lesomnus/pi400-holder/previews/connection_overview.png

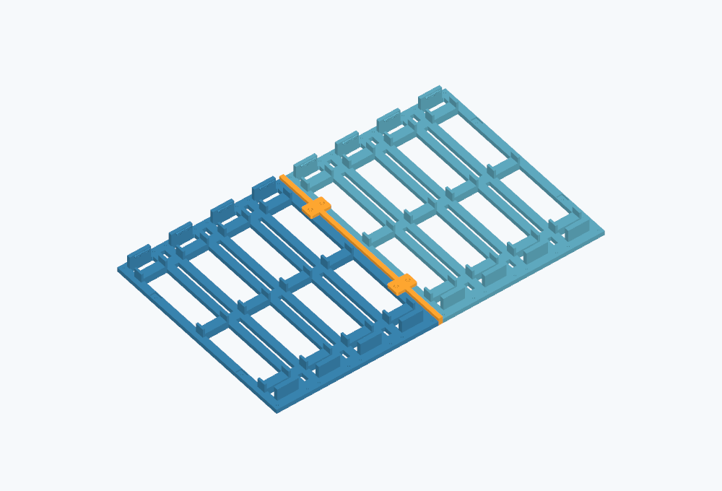
previews/connection_overview.png
