lesomnus/pi400-holder/previews/connector_underside.png

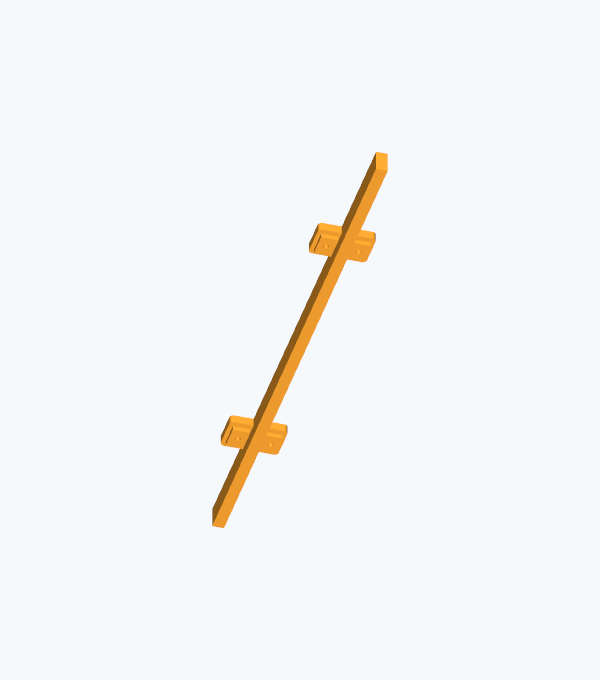
previews/connector_underside.png
