lesomnus/pi400-holder/previews/repeatable_connection.png

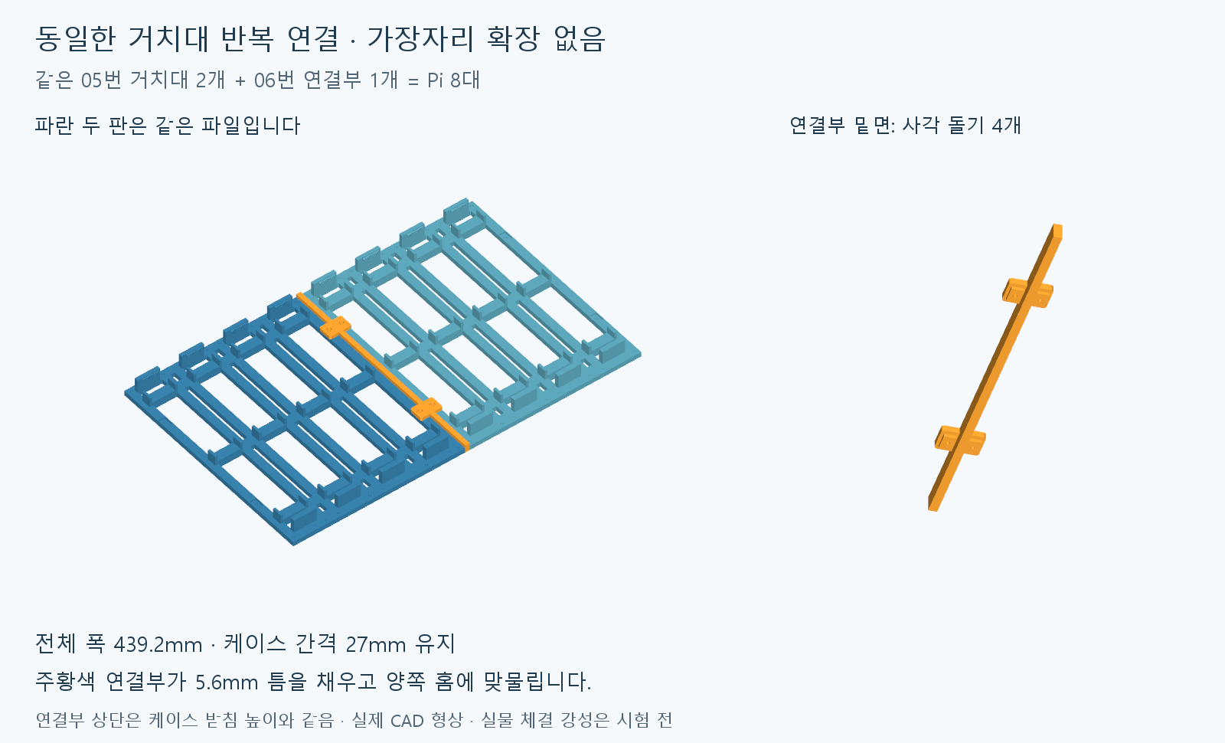
previews/repeatable_connection.png
