lesomnus/pi400-holder/reference/reference.png

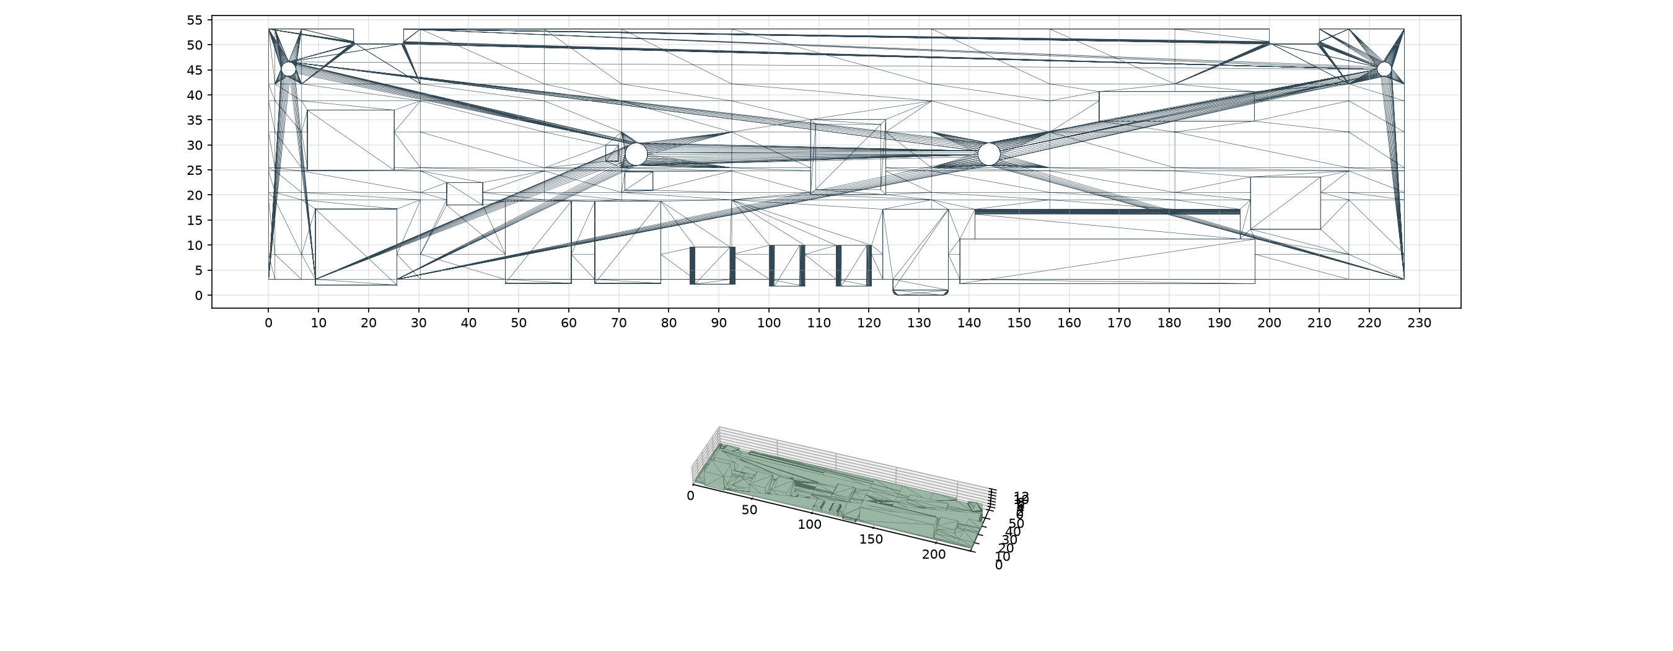
reference/reference.png
