lesomnus/pi400-holder/STEP/two_quad_connection_assembly.step

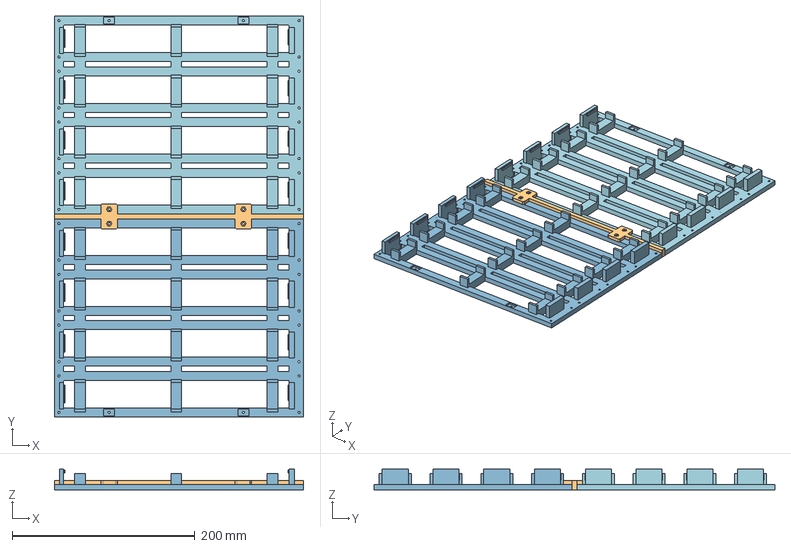
[picture p7: CAD file, 2026-10-20]
STEP/two_quad_connection_assembly.step
273.0 x 439.2 x 22.5 mm
Dock_1
Dock_2
Gap_filling_connector
