lesomnus/pi400-holder/STEP/case_assembly.step

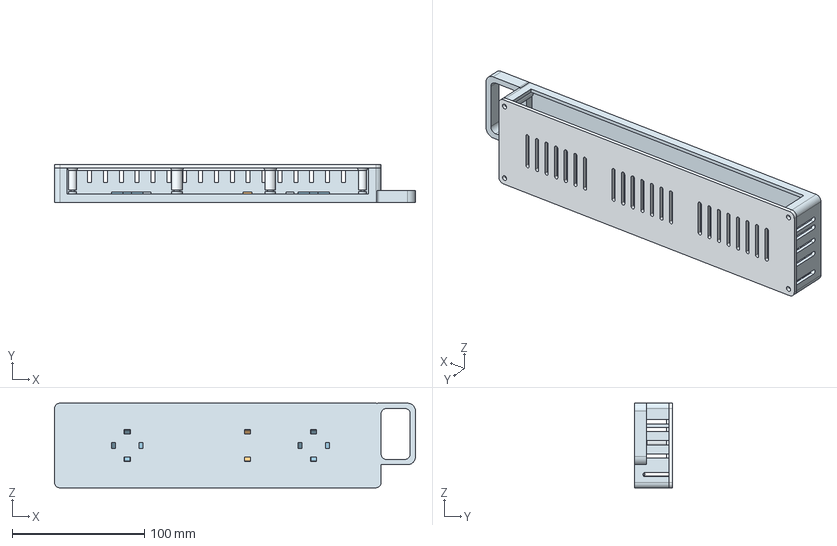
[picture p8: CAD file, 2026-10-20]
STEP/case_assembly.step
273.0 x 28.6 x 64.0 mm
Base_0
Lid_0
Guide_cap_0_0
Guide_cap_0_1
Guide_cap_0_2
