lesomnus/pi400-holder/STEP/eight_pi_assembly.step

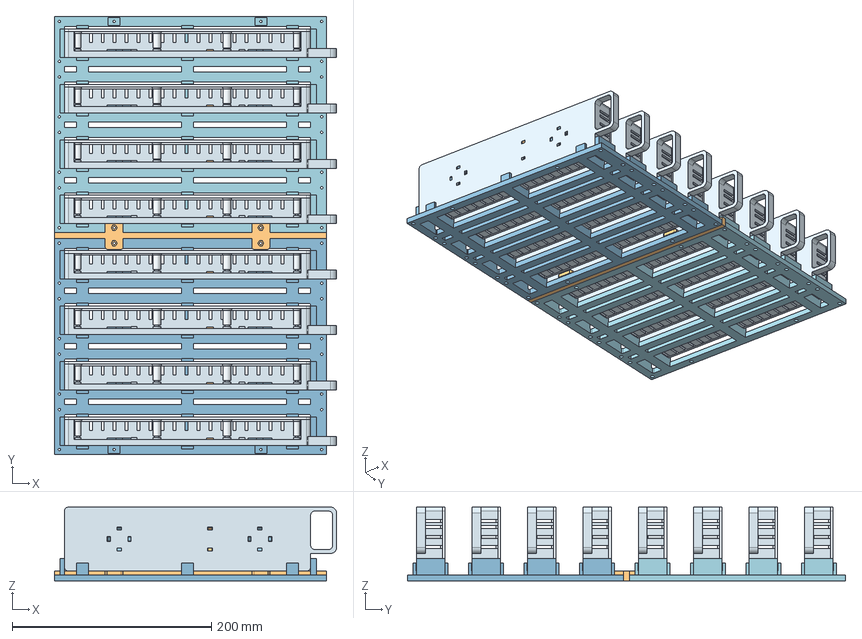
[picture p9: CAD file, 2026-10-20]
STEP/eight_pi_assembly.step
283.0 x 439.2 x 74.0 mm
Dock_1
Dock_2
Gap_filling_connector
Base_0
Lid_0
Guide_cap_0_0
Guide_cap_0_1
Guide_cap_0_2
Base_1
Lid_1
Guide_cap_1_0
Guide_cap_1_1
Guide_cap_1_2
Base_2
Lid_2
Guide_cap_2_0
Guide_cap_2_1
Guide_cap_2_2
Base_3
Lid_3
Guide_cap_3_0
Guide_cap_3_1
Guide_cap_3_2
Base_4
Lid_4
Guide_cap_4_0
Guide_cap_4_1
Guide_cap_4_2
Base_5
Lid_5
Guide_cap_5_0
Guide_cap_5_1
Guide_cap_5_2
Base_6
Lid_6
Guide_cap_6_0
Guide_cap_6_1
Guide_cap_6_2
Base_7
Lid_7
Guide_cap_7_0
Guide_cap_7_1
Guide_cap_7_2
