lesomnus/pi400-holder/reference/rpi400-pcb-reference.stl

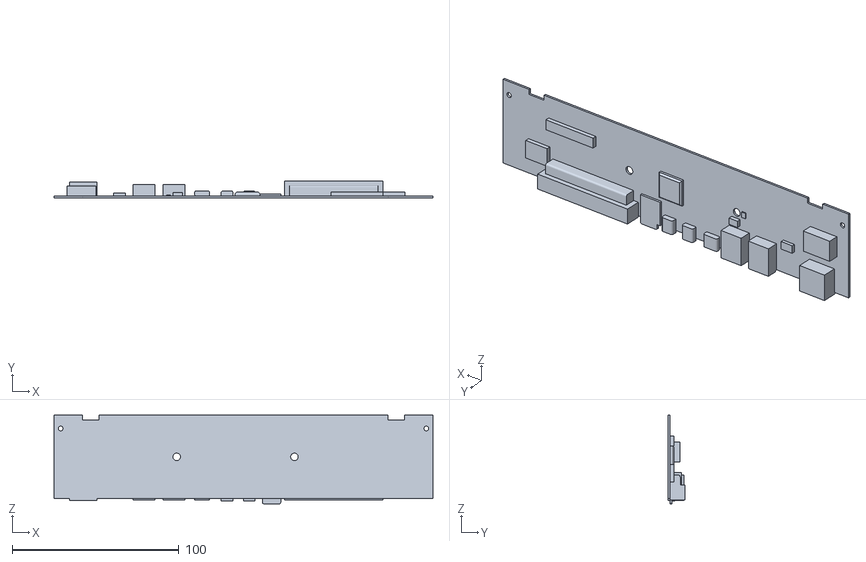
[picture p10: CAD file, 2026-10-18]
reference/rpi400-pcb-reference.stl
227.0 x 10.2 x 53.2
