lesomnus/pi400-holder/STEP/02_case_lid.step

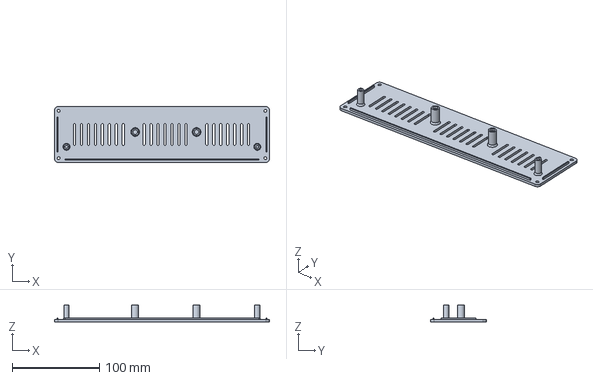
[picture p11: CAD file, 2026-10-20]
STEP/02_case_lid.step
247.0 x 64.0 x 19.1 mm
