lesomnus/pi400-holder/STEP/01_case_base.step

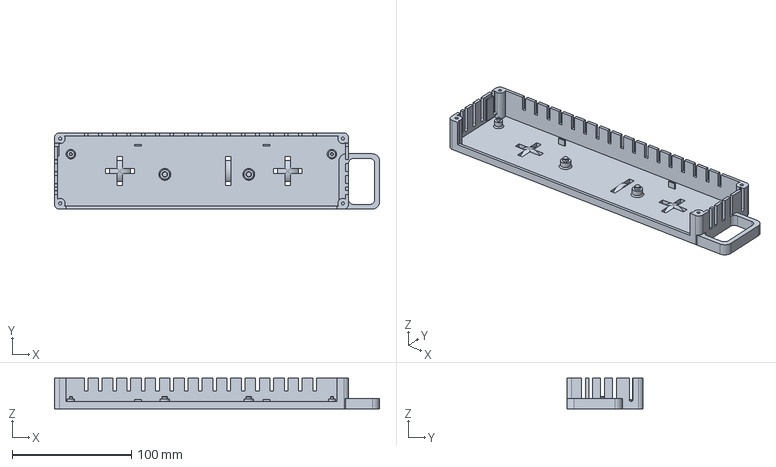
[picture p12: CAD file, 2026-10-20]
STEP/01_case_base.step
273.0 x 64.0 x 26.0 mm
