lesomnus/pi400-holder/STEP/06_gap_filling_connector.step

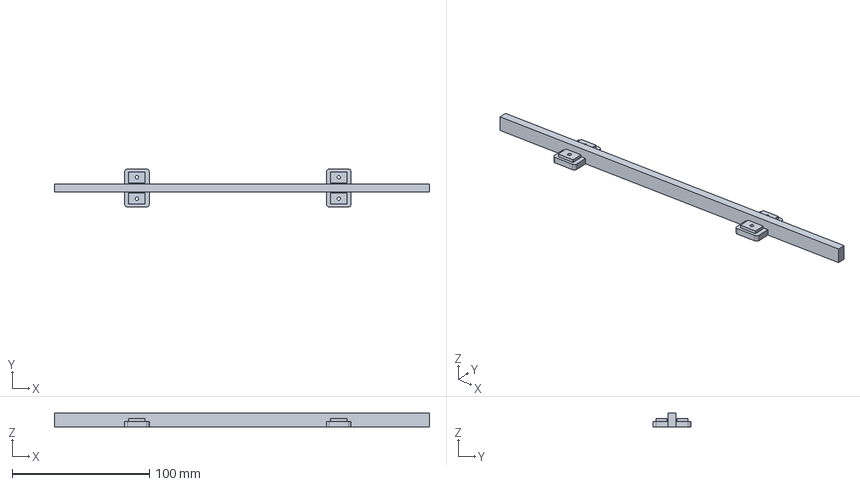
[picture p13: CAD file, 2026-10-18]
STEP/06_gap_filling_connector.step
273.0 x 27.6 x 10.0 mm
