lesomnus/pi400-holder/STEP/03_cross_guide_cap_print_2.step

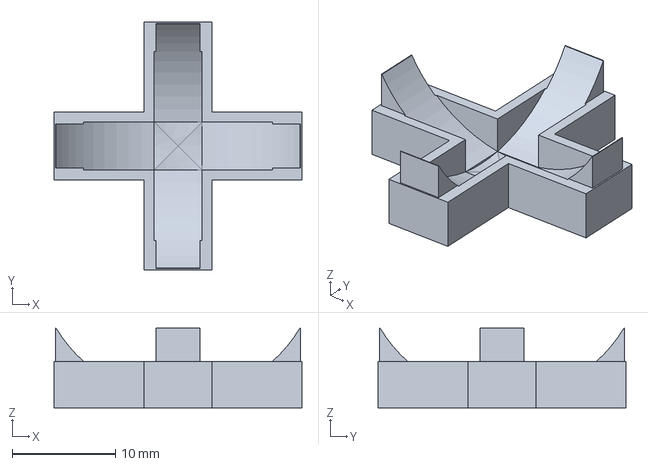
[picture p14: CAD file, 2026-10-18]
STEP/03_cross_guide_cap_print_2.step
24.0 x 24.0 x 7.70 mm
