lesomnus/pi400-holder/STEP/05_quad_dock_repeatable.step

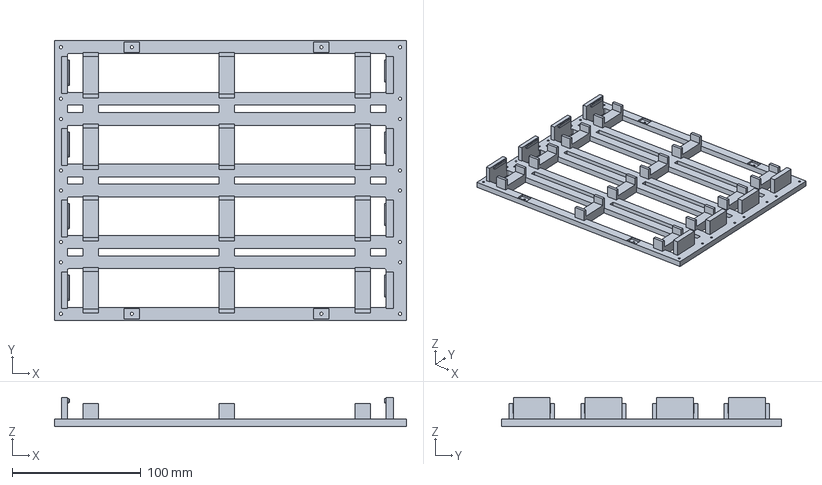
[picture p15: CAD file, 2026-10-18]
STEP/05_quad_dock_repeatable.step
273.0 x 216.8 x 22.5 mm
