lesomnus/pi400-holder/STEP/08_depth_link_optional.step

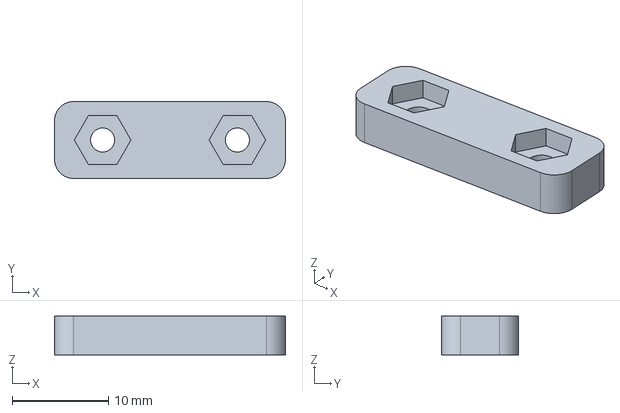
[picture p16: CAD file, 2026-10-18]
STEP/08_depth_link_optional.step
24.0 x 8.00 x 4.00 mm
