lesomnus/pi400-holder/STEP/04_single_guide_cap_print_1.step

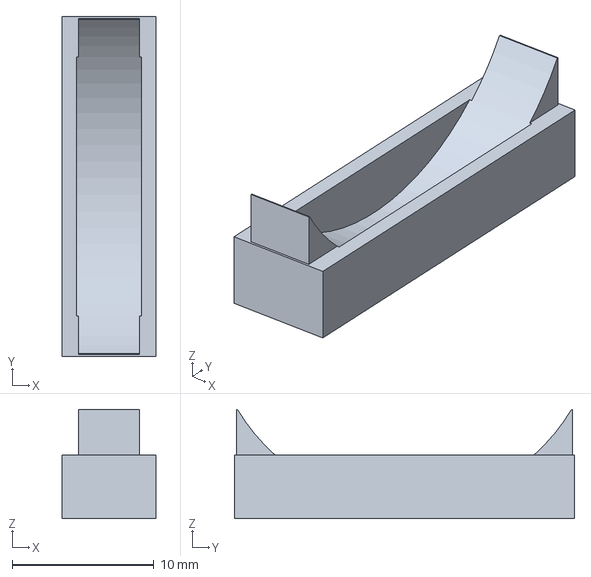
[picture p17: CAD file, 2026-10-18]
STEP/04_single_guide_cap_print_1.step
6.60 x 24.0 x 7.70 mm
