lesomnus/pi400-holder/(list of files, cad)

Other CAD files:
STL/01_case_base.stl
STL/02_case_lid.stl
STL/03_cross_guide_cap_print_2.stl
STL/04_single_guide_cap_print_1.stl
STL/05_quad_dock_repeatable.stl
STL/06_gap_filling_connector.stl
STL/08_depth_link_optional.stl
