lesomnus/pi400-holder/previews/extra_poe_guide_preview.png

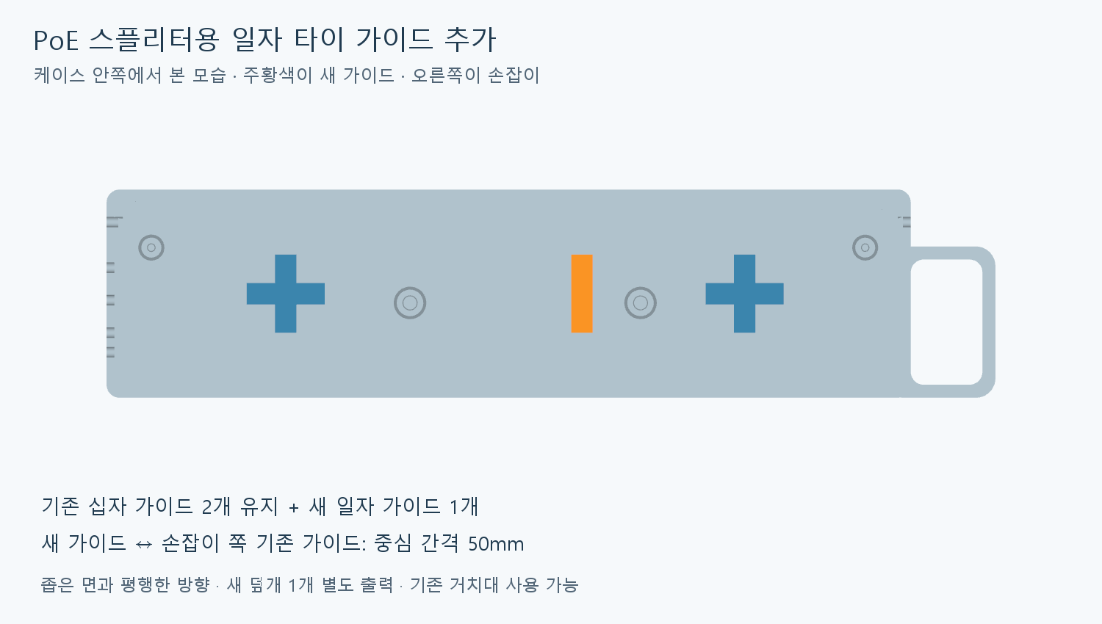
previews/extra_poe_guide_preview.png
