lesomnus/pi400-holder/(commit log)

2026-10-18 Add Pi 400 PCB case and modular rack holder
2026-10-18 Add case assembly and exploded previews to README
2026-10-19 Restore far PCB mount and move handle-side mount inward 0.8mm
2026-10-20 Move far PCB mount 0.5mm farther from handle
2026-10-25 Record successful physical fit of final printed design
